heavy2119/Belt-tensioner-AC-Servo-/README.md

# Belt Tensioner (AC Servo Version)

AC Servo based belt tensioner for **Sim Racing**, built using a Panasonic Minas A4 servo system.

This project is based on the original DIY belt tensioner project:

https://www.simhubdash.com/diy-belt-tensionner/

---

# Overview

This project uses:

* Panasonic **Minas A4 100W AC Servo**
* **ATG PGX42-20** planetary reducer
* Arduino control
* Hall sensor for homing

The goal was to build a **quiet and responsive belt tensioner system** for SimHub.

---

<p align="left">
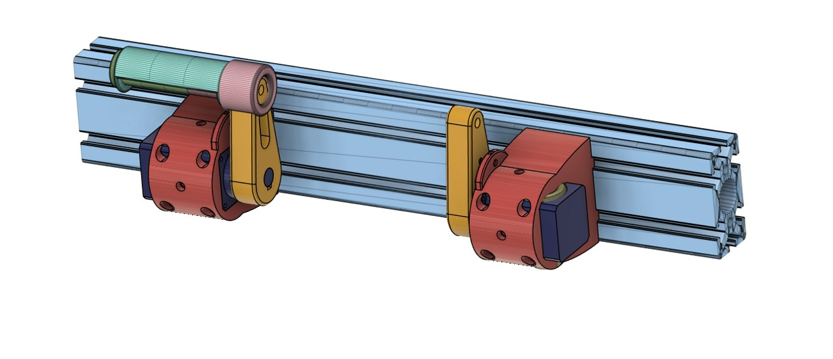
[picture p1: image/전체사진.jpg]

</p>

<p align="left">
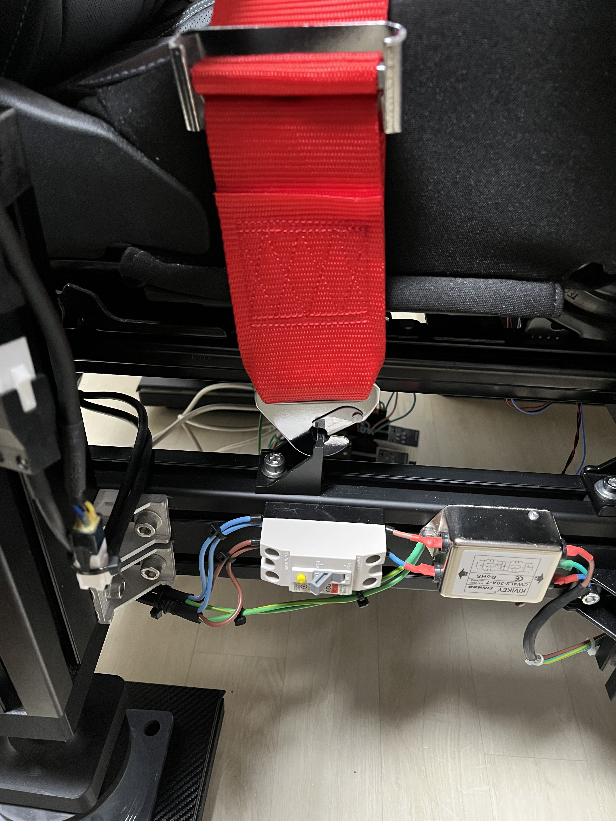
[picture p2: image/belt.jpg]

</p>

---

# Hardware

## Main Components

<p align="left">
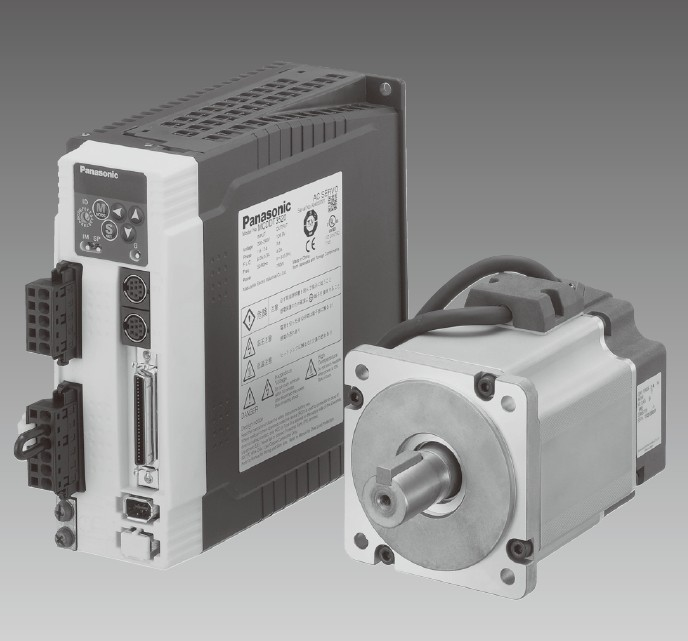
[picture p3: image/MinasA4.jpg]

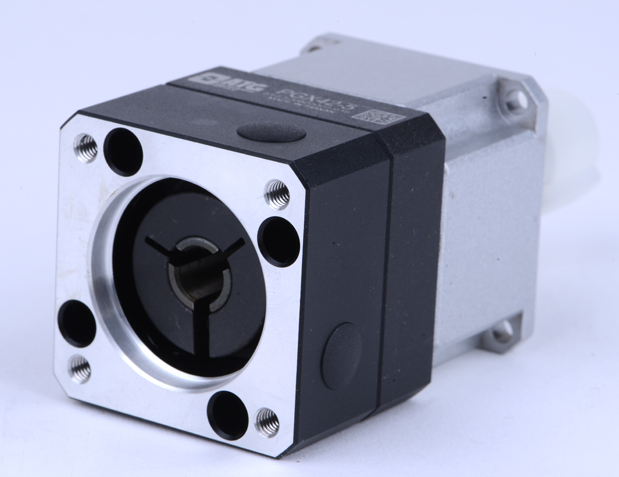
[picture p4: image/pgx42.png]

</p>

| Component | Model | Note |
| --- | --- | ---|
| Servo Driver | MADDT1205 | |
| Servo Motor  | MSMD012S1A | |
| Reducer | ATG PGX42-20 | |
| Reducer | PLF042-L2-8-30-46-M4| 타오바오에서 구매 가능 [Buy](https://item.taobao.com/item.htm?id=677023837529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)|

---

# Arduino Wiring (Board Type)

<p align="left">
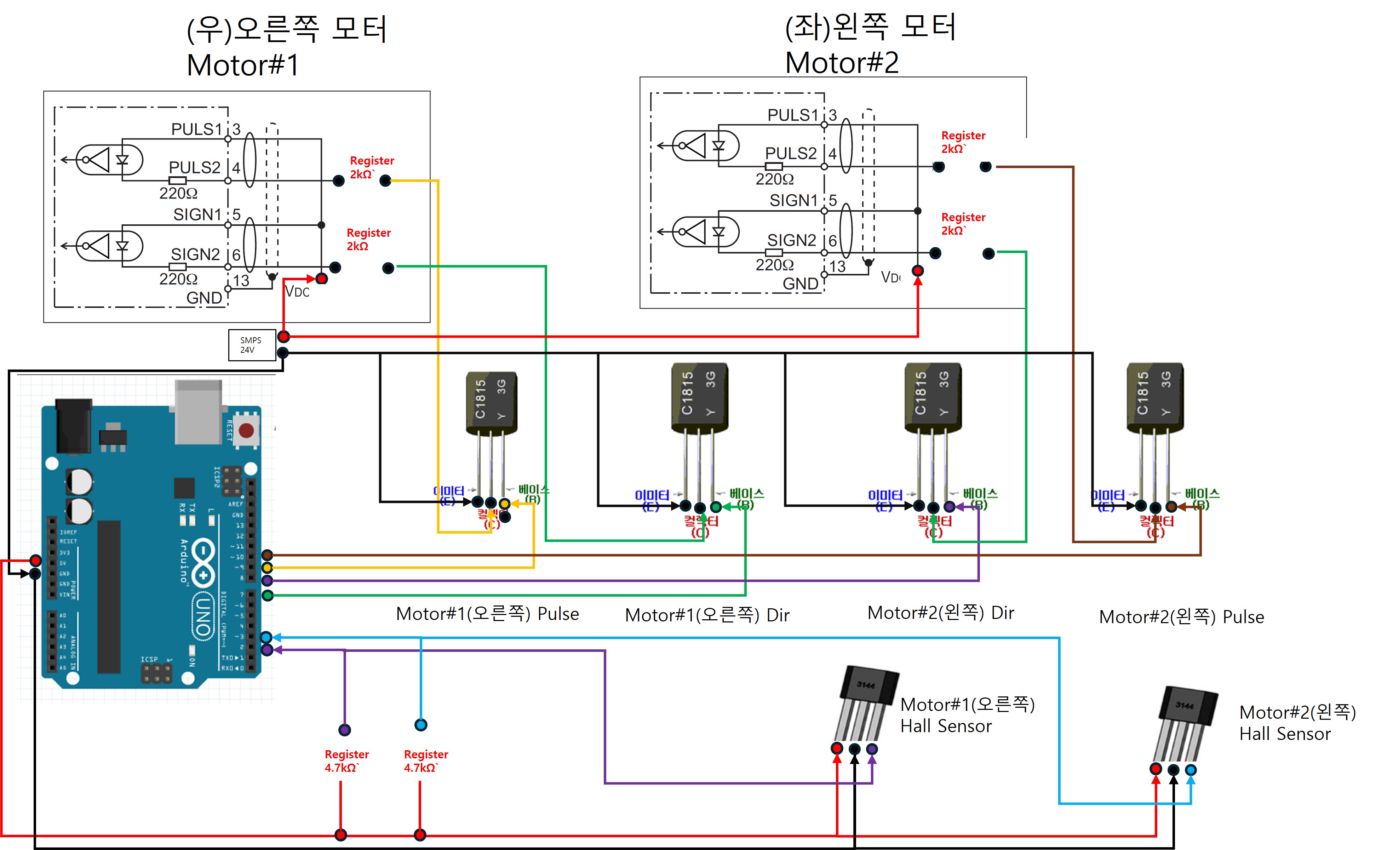
[picture p5: image/Arduino Wirling.jpg]

</p>

| Function | Motor 1 | Motor 2 | Servo I/O |
| --- | --- | --- | --- |
| Pulse | 9 | 10 | 4 |
| Direction | 7 | 8 | 6 |
| Hall Sensor | 2 | 3 | - |
| 24V+ | | | 3,5 |

# Arduino Wiring (PCB Type / I/O(3,4,5,6))

<p align="left">
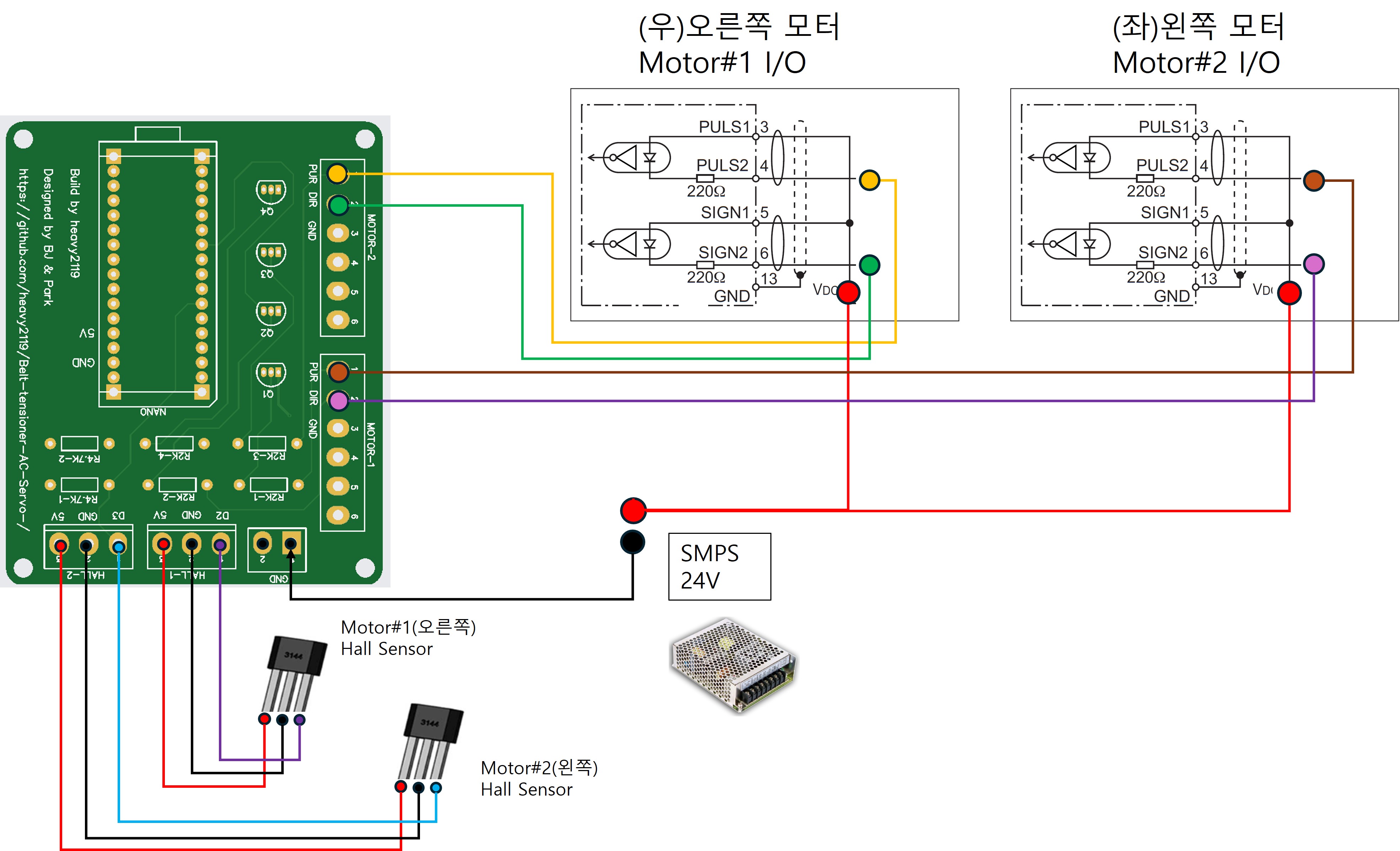
[picture p6: image/PCB Type 3,4,5,6 Pin활용.jpg]

</p>

| Function | Motor 1 | Motor 2 | Servo I/O |
| --- | --- | --- | --- |
| Pulse | 9 | 10 | 4 |
| Direction | 7 | 8 | 6 |
| Hall Sensor | 2 | 3 | - |
| 24V+ | | | 3,5 |

# Arduino Wiring (PCB Type / OPC사용 I/O(1,4,2,6))

<p align="left">
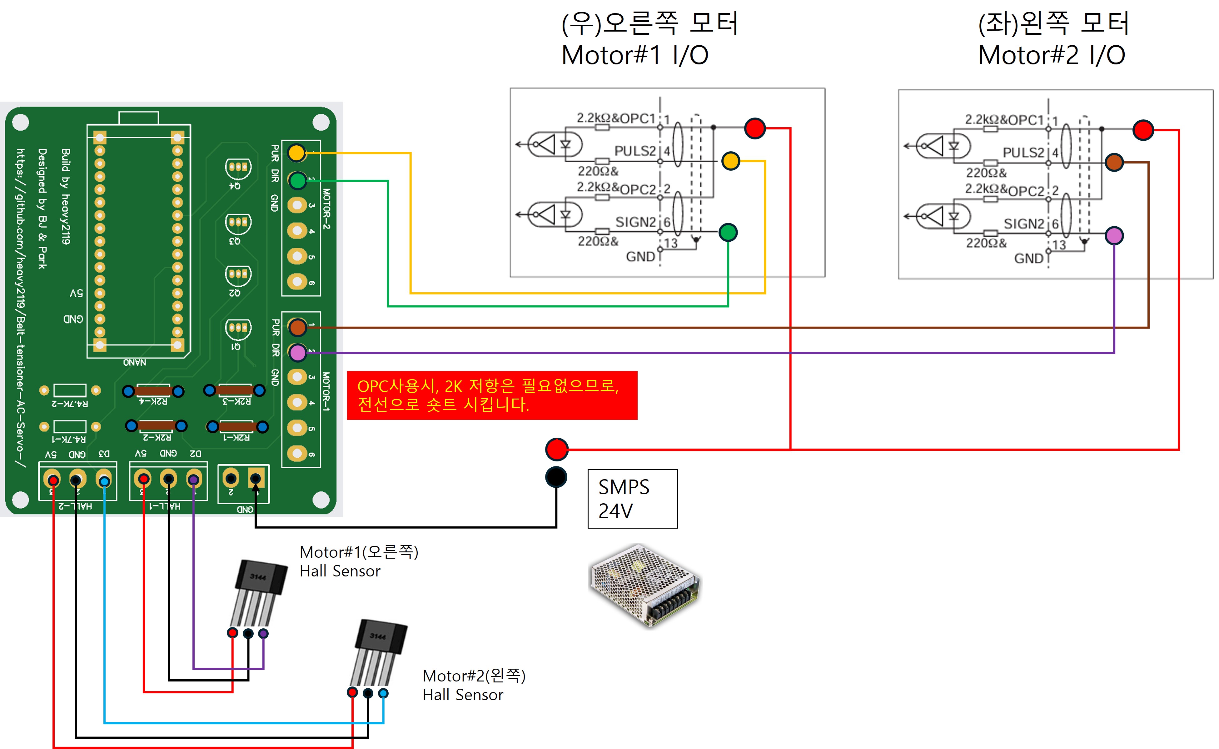
[picture p7: image/PCB Type 1,4,2,6 Pin활용.jpg]

</p>

| Function | Motor 1 | Motor 2 | Servo I/O |
| --- | --- | --- | --- |
| Pulse | 9 | 10 | 4 |
| Direction | 7 | 8 | 6 |
| Hall Sensor | 2 | 3 | - |
| 24V+ | | | 1,2 |

# Arduino Wiring (NEW PCB Type Type /OPC사용 I/O(1,4,2,6))

<p align="left">
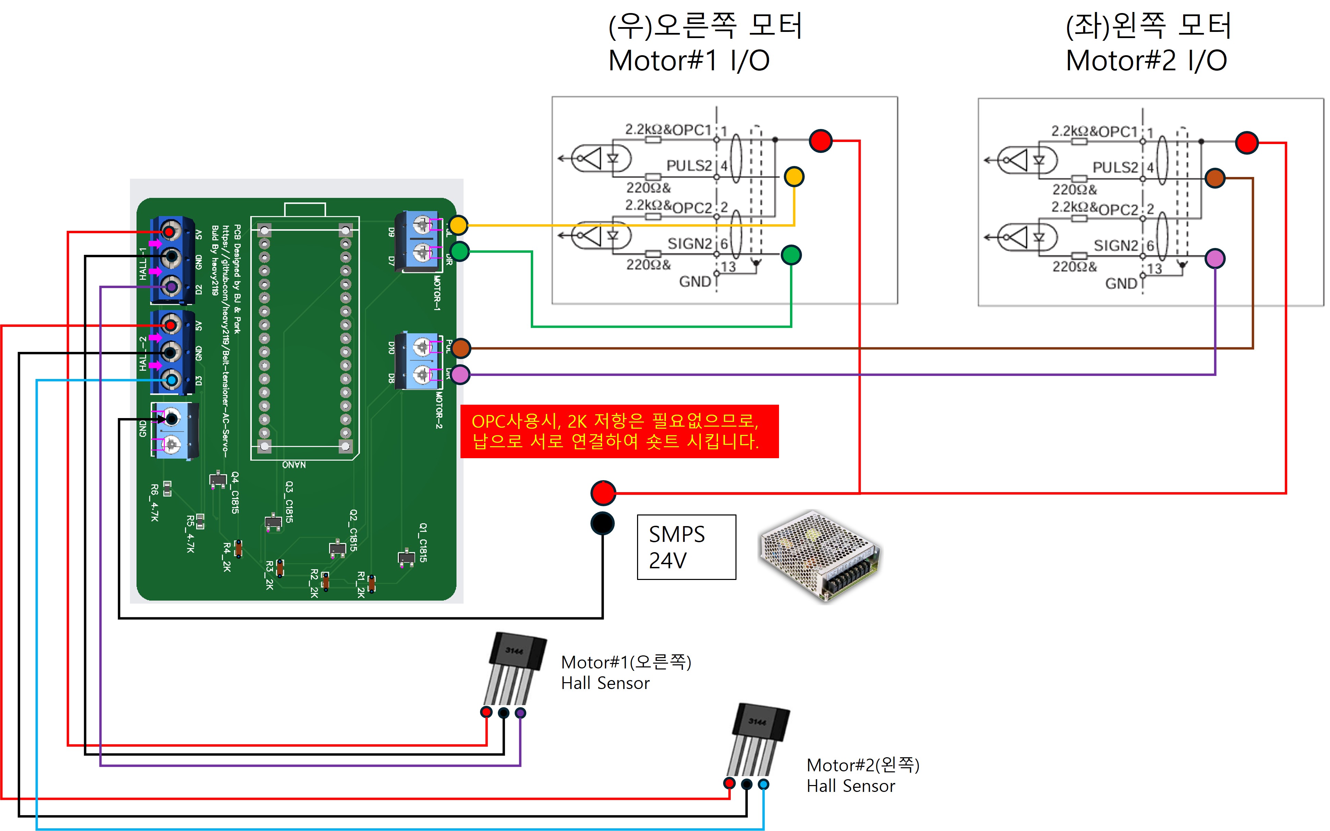
[picture p8: image/NEW PCB.jpg]

</p>

| Function | Motor 1 | Motor 2 | Servo I/O |
| --- | --- | --- | --- |
| Pulse | 9 | 10 | 4 |
| Direction | 7 | 8 | 6 |
| Hall Sensor | 2 | 3 | - |
| 24V+ | | | 1,2 |

---

# Servo I/O Pin Map

<p align="left">
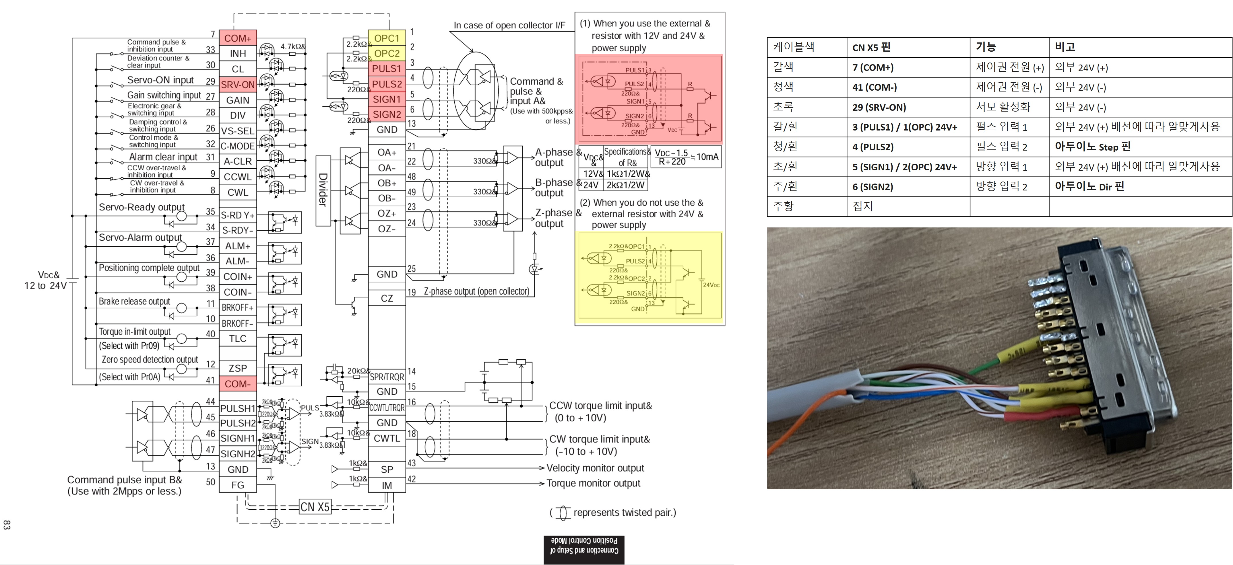
[picture p9: image/IO Wirling.jpg]

</p>

| Pin | Signal | Connection |
| --- | --- | --- |
| 3 | PULS1 / OPC1  | 24V+ |
| 4 | PULS2 | 0V (<- Arduino INPUT) |
| 5 | SIGN1 / OPC2  | 24V+ |
| 6 | SIGN2 | 0V (<- Arduino INPUT) |
| 7 | COM+ | 24V+ |
| 29  | SRV-ON | 0V |
| 41  | COM- | 0V |

---

# Minas A4 Servo Drive Parameters

| Parameter | Description | Value | Note |
| --- | --- | ----- | ----- |
| Pr02 | Control Mode | 0 | |
| Pr04 | Disable Over-travel Input | 1 | |
| Pr40 | Command Pulse Input | 0 | |
| Pr42 | Pulse Input Mode | 3 | |
| Pr43 | Pulse Input Inhibition | 1 | |
| Pr4E | Counter Clear Mode | 2 | |
| Pr4B | Electronic Gear Denominator | 150 | 감속비 20:1 |

# Minas A5 Servo Drive Parameters

| Parameter | Description | Value | Note |
| --- | --- | ----- |----- |
| Pr01 | Control Mode | 0 | |
| Pr05 | Disable Over-travel Input | 0 | |
| Pr06 | Command Pulse Input | 1 | |
| Pr07 | Pulse Input Mode | 3 | |
| Pr08 | Command pulse counts per one motor revolution | 600 |  감속비 5:1 |

---

# Part List (모든전장품은 여유분을 꼭 가지고 사세요.) 

| Name | EA | Site | Note | 
| --- | --- | --- | --- |
| PCB  | 1 |  [Buy](https://github.com/heavy2119/Belt-tensioner-AC-Servo-/tree/main/PCB)| Gerber_Belt-tensioner.ZIP / BOM / CPL << 옵션에 PCB어샘블리 선택하고 첨부, BOM 단계에서 없는파츠는 선택할것, KF301은 구성요소배치에서 회전시킬것!
| PCB  | 1 |  [Buy](https://github.com/heavy2119/Belt-tensioner-AC-Servo-/tree/main/PCB)| Gerber_Belt-tensioner-AC-Servo_PCB_Belt-tensioner-AC-Servo_2026-04-20.zip / 수동 납땜 버전용!!, 이버전은 아래 Part가 전부 필요.
| Arduino Nano  | 1 |  [Buy](https://smartstore.naver.com/misoparts/products/9353232362)| 
| Arduino Nano 소켓  | 1 |  [Buy](https://smartstore.naver.com/misoparts/products/5685496972)| 
| PCB 소켓  | 1 |  [Buy](https://ko.aliexpress.com/item/1005010243767312.html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)|  KF301-5.0-2P / PCB 어샘블리 버전 주문시 불필요!!
| PCB 소켓  | 2 |  [Buy](https://ko.aliexpress.com/item/1005010243767312.html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)|  KF301-5.0-3P / PCB 어샘블리 버전 주문시 불필요!!
| PCB 소켓  | 2 |  [Buy](https://ko.aliexpress.com/item/1005010243767312.html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)|  KF301-5.0-6P / PCB 어샘블리 버전 주문시 불필요!!
| 드라이버 I/O 케이블  | 2 |  [Buy](https://item.taobao.com/item.htm?id=1012712594796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)| 松下X4控制线 << 항목 선택 주문
| 드라이버 엔코더,전원 케이블  | 2 |  [Buy](https://item.taobao.com/item.htm?id=1043514073575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)| 松下A4A5编码器线+动力线一套 << 항목 선택 주문
| 12 or 24V SMPS | 1 | [Buy](https://smartstore.naver.com/jooyontns/products/498258307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)|  
| A3144 Hall Sensor | 2 | [Buy](https://smartstore.naver.com/misoparts/products/7329734570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) |  원점 감지용
| C1815 TR | 4 | [Buy](https://smartstore.naver.com/misoparts/products/11061354807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)|  PCB 어샘블리 버전 주문시 불필요!!
| 저항 1k | 8 | [Buy](https://smartstore.naver.com/misoparts/products/12929684410) | 2K 저항이 필요, 1K 2개 직렬사용 / PCB 어샘블리 버전 주문시 불필요!!
| 저항 1K ~ 4.7k | 2 | [Buy](https://smartstore.naver.com/misoparts/products/12929684410) | 평균 4.7K옴을 사용하나, 환경에 따라 틀림 / 풀업 저항 사용(노이즈억제) / PCB 어샘블리 버전 주문시 불필요!!
| 전선 AWG24 X 8C | 1 | [Buy](https://smartstore.naver.com/ctkmall/products/9391403956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)| 10미터 정도?
| Magnet 6X3 | 2 |  [Buy](https://smartstore.naver.com/3hl) | 네오디움 자석
| 4Point Belt | 1 | [Buy](https://item.taobao.com/item.htm?id=839255746083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)  | 안전밸트
| Die-Casting Bracket for Profile 40X40 | 2 |  | 안전벨트 걸이  |
| M4X10 | 8 |  | Motor ↔ 감속기 체결용 볼트 (여유분있게 구매) |
| M5X15 | 8 |  | Motor 3D Print 체결용 볼트 (여유분있게 구매) |
| M6X110 | 2 |  | 안전벨트 체결용 볼트 (여유분있게 구매) |
| M8X15 | 8 |  | 다이닝캐스팅 고정용 볼트 (여유분있게 구매)  |
| M6 NUT | 2 |  | 안전벨트 체결용 너트 (여유분있게 구매)  |
| 40 T Nut | 2 |  | 다이닝캐스팅 고정용 T Nut (여유분있게 구매)  |

---

# 3D Print

| Name |  EA  | Note |
| --- |  --- |--- |
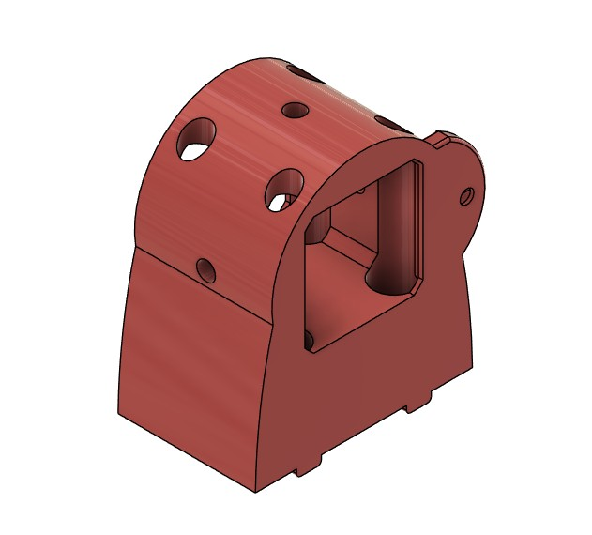
[picture p10: image/감속기마운트(좌).jpg]
|   |  1EA  |  ATG PGX42-20 전용 (내경 43mm)
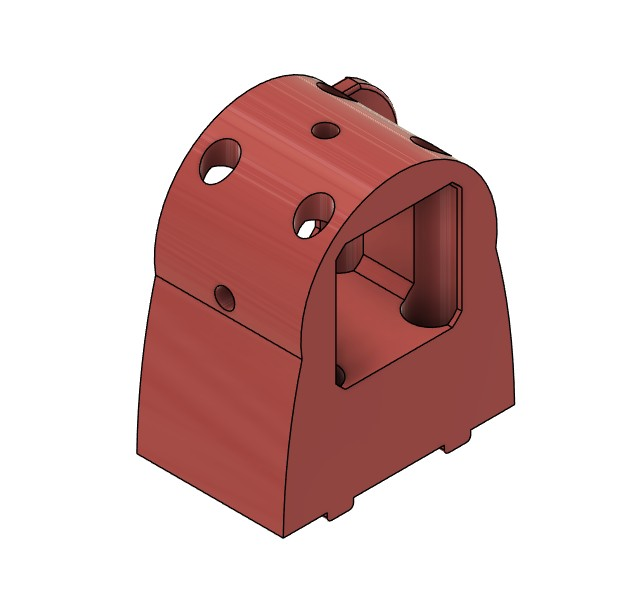
[picture p11: image/감속기마운트(우).jpg]
|  |  1EA |  ATG PGX42-20 전용 (내경 43mm)
|   |  1EA  | (내경 42.7mm)
|  |  1EA | (내경 42.7mm)
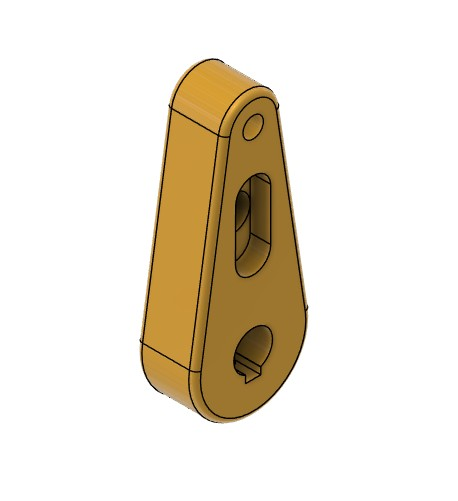
[picture p12: image/레버(좌).jpg]
|  | 1EA
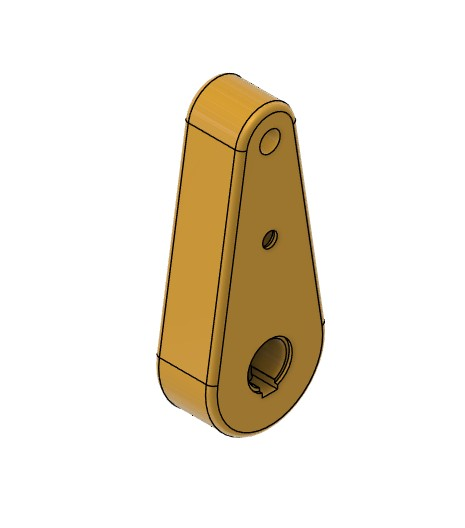
[picture p13: image/레버(우).jpg]
|  |  1EA
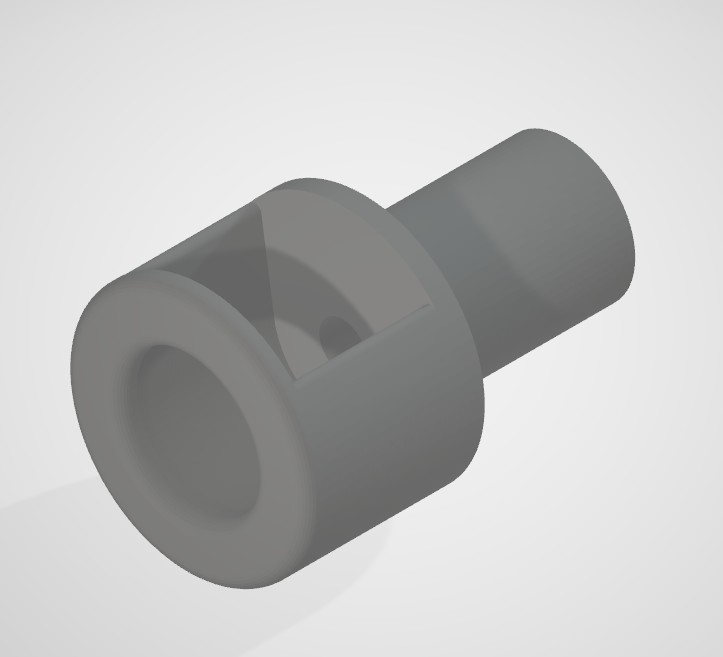
[picture p14: image/Arm1.jpg]
|  |  1EA | By https://www.simhubdash.com/diy-belt-tensionner/
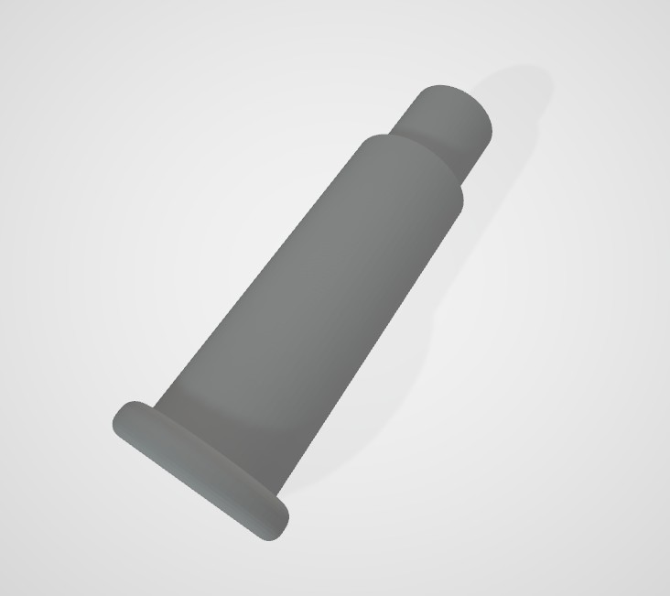
[picture p15: image/Rod2_76mm.jpg]
|  |  1EA | By https://www.simhubdash.com/diy-belt-tensionner/
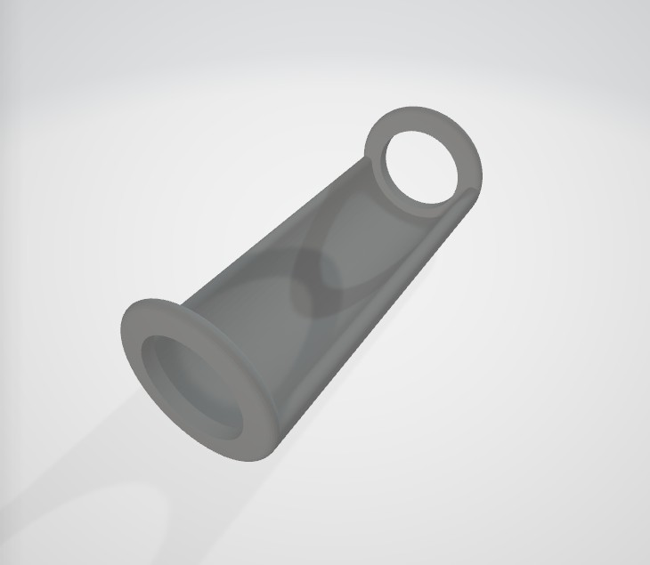
[picture p16: image/BeltClamp_76mm.jpg]
|  |  1EA | By https://www.simhubdash.com/diy-belt-tensionner/

# Arduino Source Check List

| Name | Value | 
| --- | --- |
| totalWorkingRange | 1500 |
| stepper1_directionPin |  7 |
| stepper1_enablePin  | 11 |
| stepper1_hallSensorPin |  2 |
| stepper2_directionPin | 8 |
| stepper2_enablePin | 13 |
| stepper2_hallSensorPin | 3 |

## 🇰🇷 아두이노 테스트 주의사항
초기 실행시 const bool sensorTestMode = false; 값을 True로 변경하여
자석을 감지시켜 센서가 정상적으로 동작하는지 확인한다.

정상 동작 확인후 true로 변경한다

이후 심허브에서 캘리브레이션을 실행하면 아래의 동영상과 같이
초기화가 되어야 한다

주의 : 절대 리그에 장착한 상태에서 테스트 하지말고 바닥에 두고
테스트 할것. 초기화 불가시 arm이 파손될수 있음

Watch the video (https://youtube.com/shorts/3xaYN5WgsHA)

---

## 🇺🇸 Arduino Test Notice

During the initial run, change the value of const bool sensorTestMode = false; to true, 
then trigger the magnet to verify that the sensor is operating correctly.

---

# Assembly Notes

<p align="left">
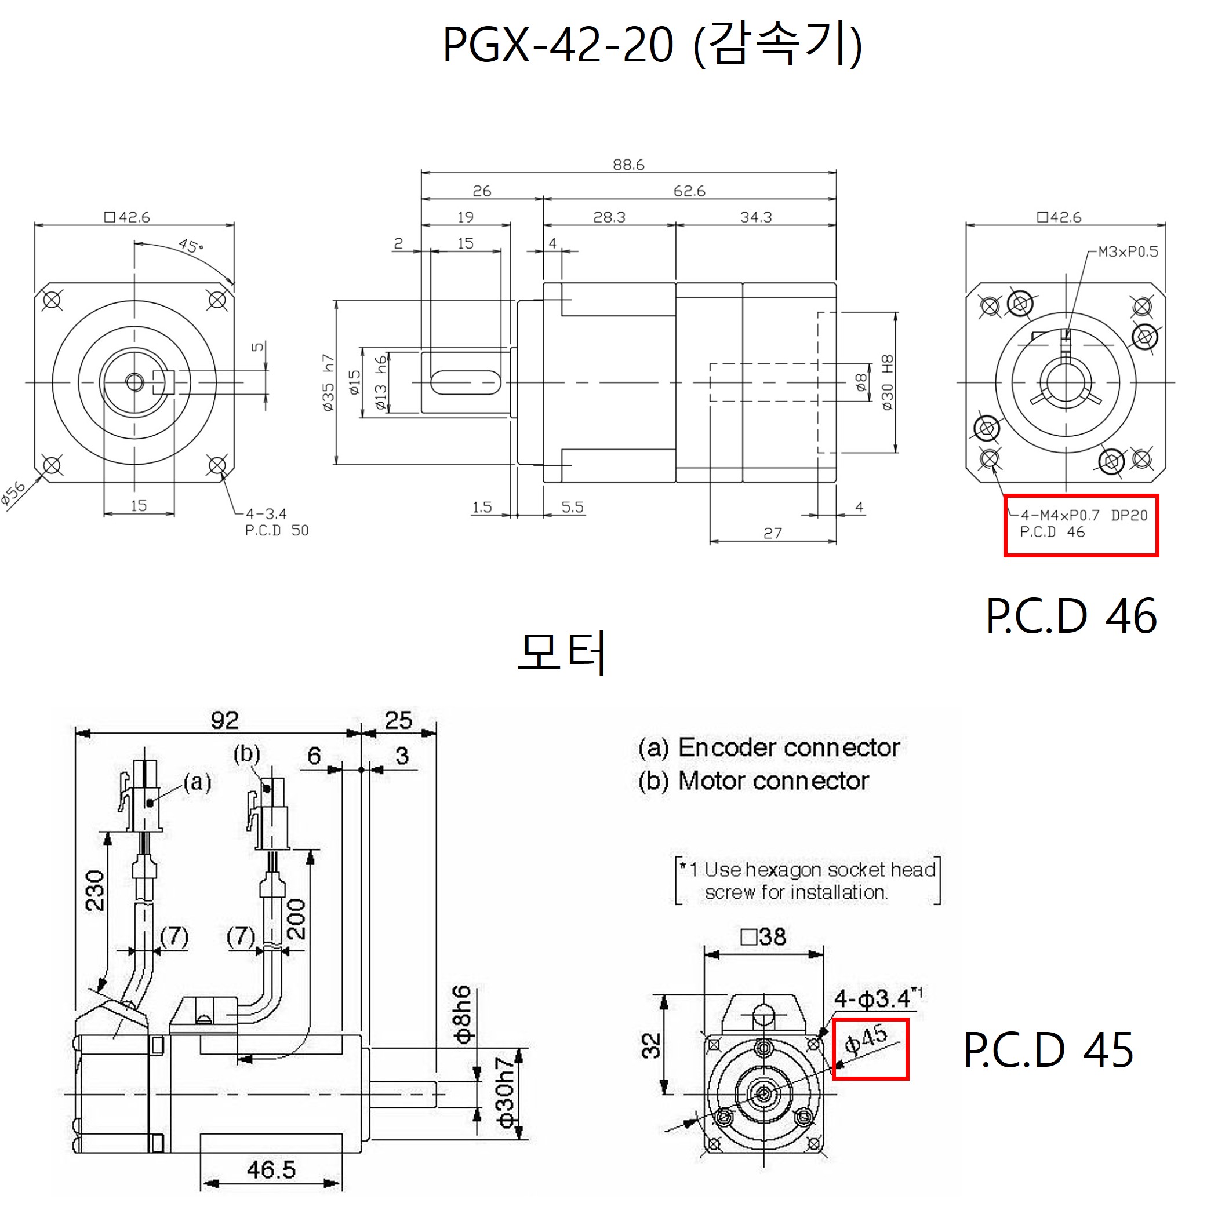
[picture p17: image/size.jpg]

</p>

## 🇰🇷 조립 주의사항

- 감속기 P.C.D : 46 mm  
- 모터 P.C.D : 45 mm  

두 부품의 P.C.D 차이가 **1 mm** 있어 볼트 구멍이 정확히 맞지 않습니다.  

따라서 모터쪽 **M4 볼트가 들어갈 수 있도록 드릴로 구멍을 확장해야 합니다.**  

저는 약 **Ø6.5 mm** 정도로 구멍을 확장하여 사용했습니다.

---

## 🇺🇸 Assembly Notes

- Gearbox P.C.D: 46 mm  
- Motor P.C.D: 45 mm  

Because there is a **1 mm difference in the P.C.D**, the bolt holes do not align perfectly.  

Therefore, **the holes need to be enlarged with a drill** so that the M4 bolts on the motor side can fit.  

In my case, I enlarged the holes to approximately **Ø6.5 mm**.

---

# Credits

Original project inspiration:

DIY Belt Tensioner
https://www.simhubdash.com/diy-belt-tensionner/
