heavy2119/Belt-tensioner-AC-Servo-/image/Driver Parameter Setting.jpg

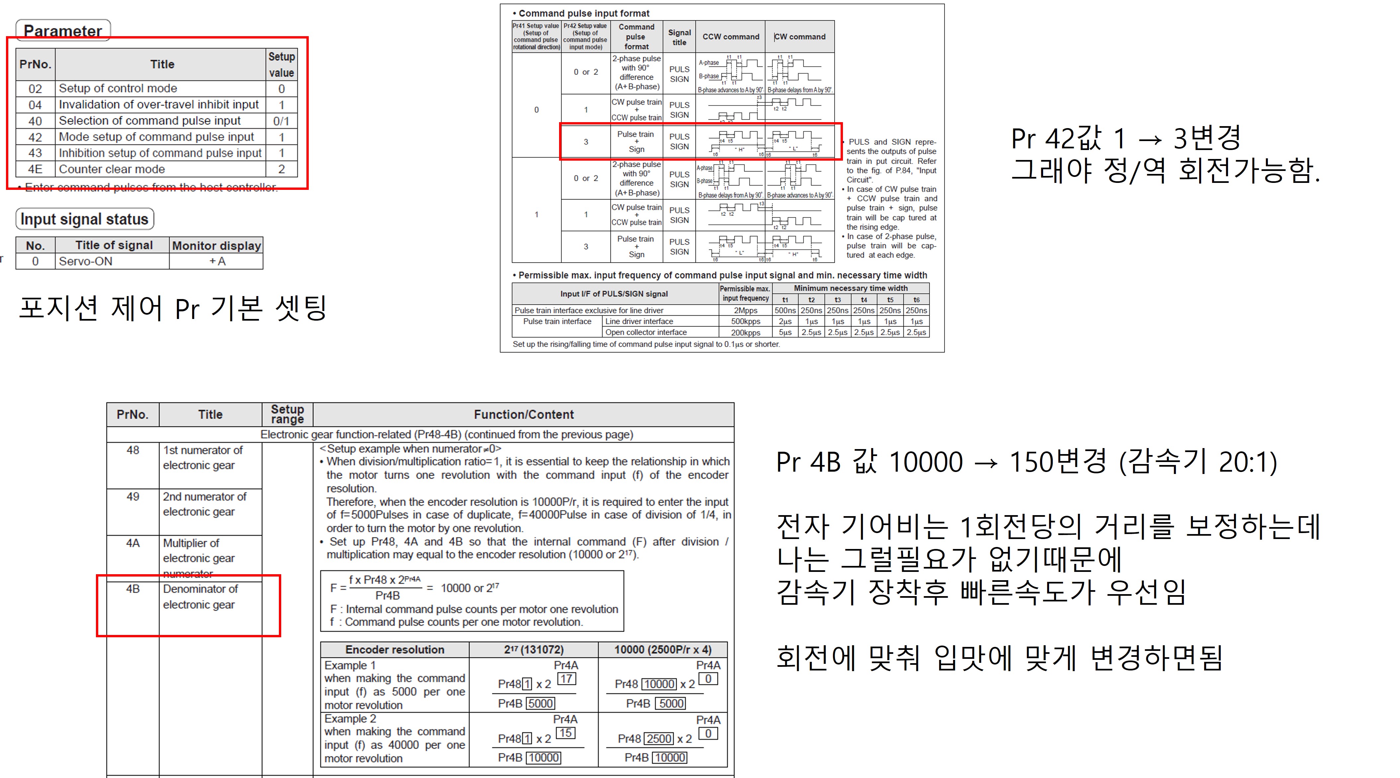
image/Driver Parameter Setting.jpg
