heavy2119/Belt-tensioner-AC-Servo-/3D Print/레버 감속기마운트 42.7(좌)).stl

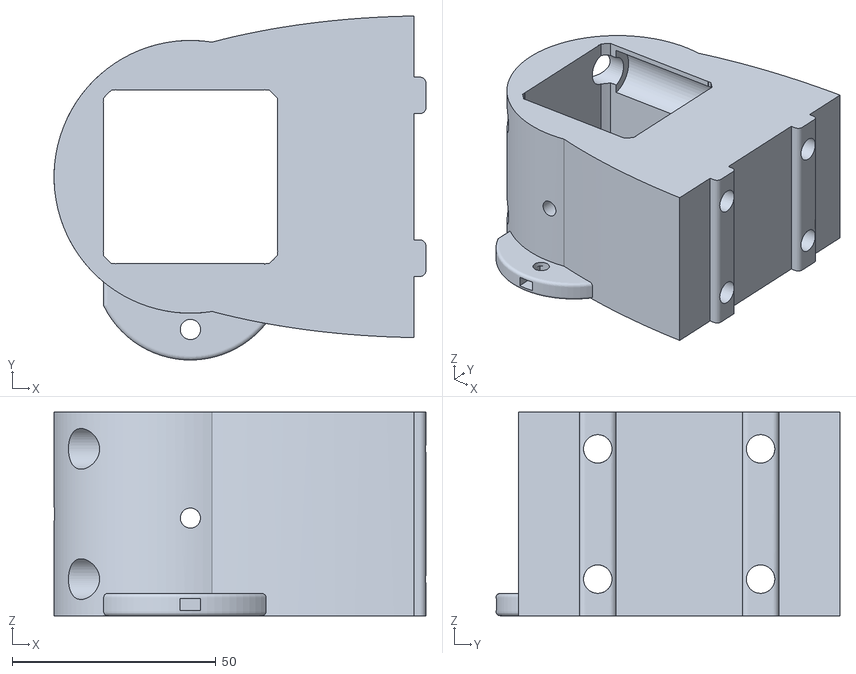
[picture p19: CAD file, 2026-08-10]
3D Print/레버 감속기마운트 42.7(좌)).stl
91.4 x 84.5 x 50.0
