heavy2119/Belt-tensioner-AC-Servo-/3D Print/레버(좌) Nut추가.stl

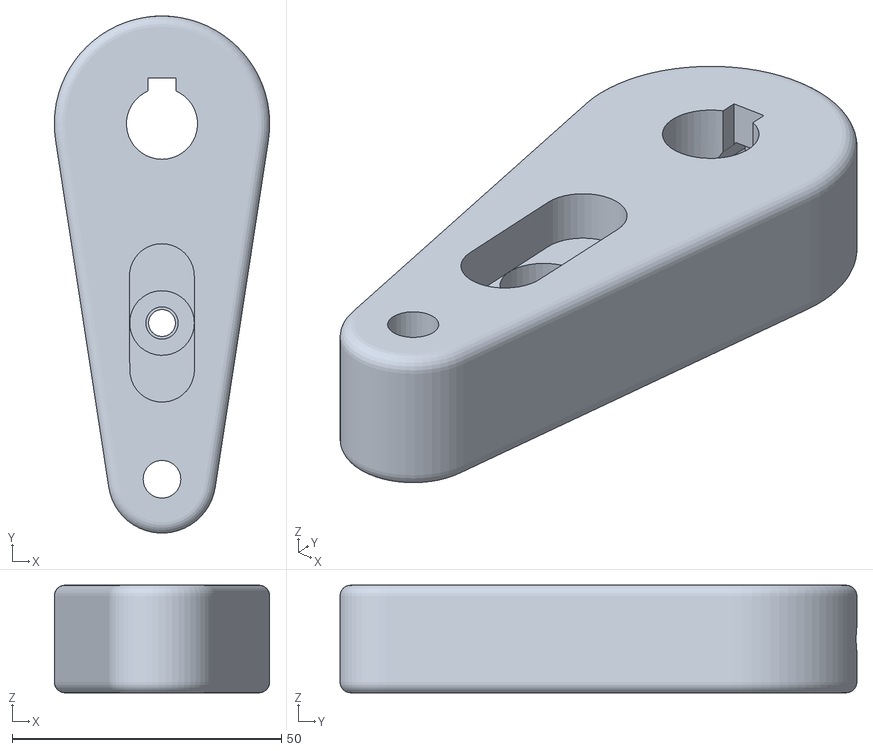
[picture p20: CAD file, 2026-06-20]
3D Print/레버(좌) Nut추가.stl
40.0 x 96.0 x 20.0
