heavy2119/Belt-tensioner-AC-Servo-/3D Print/BeltClamp_76mm.stl

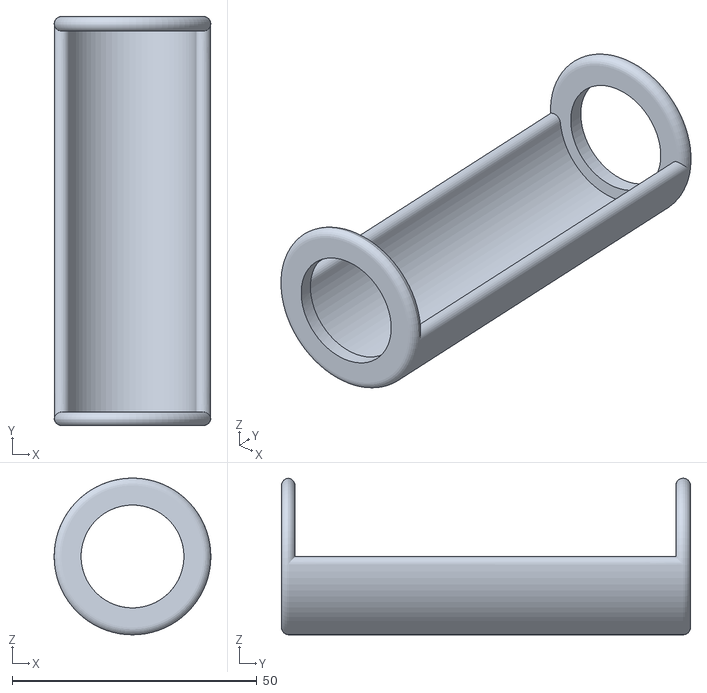
[picture p21: CAD file, 2026-04-01]
3D Print/BeltClamp_76mm.stl
32.0 x 83.5 x 32.0
