heavy2119/Belt-tensioner-AC-Servo-/3D Print/Arm1.stl

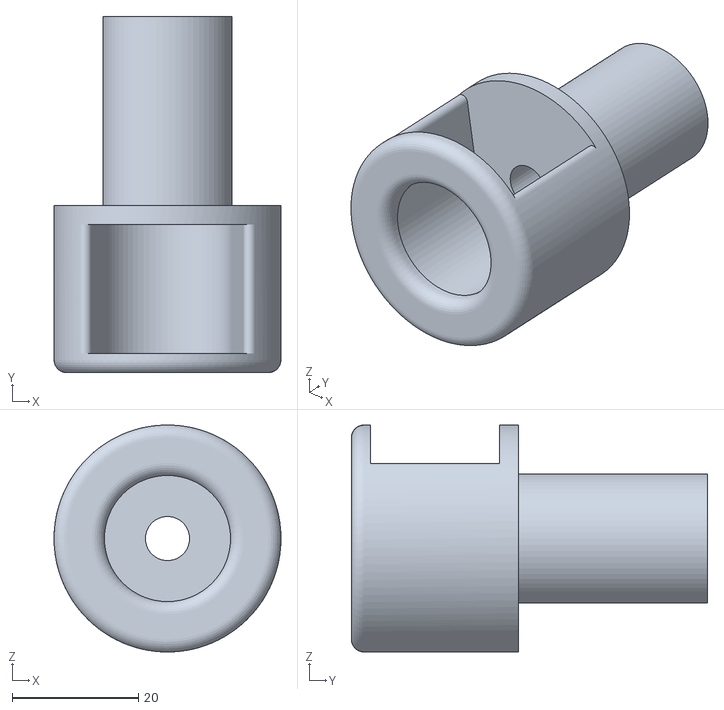
[picture p22: CAD file, 2026-04-01]
3D Print/Arm1.stl
36.0 x 56.5 x 36.0
