heavy2119/Belt-tensioner-AC-Servo-/3D Print/Rod2_76mm.stl

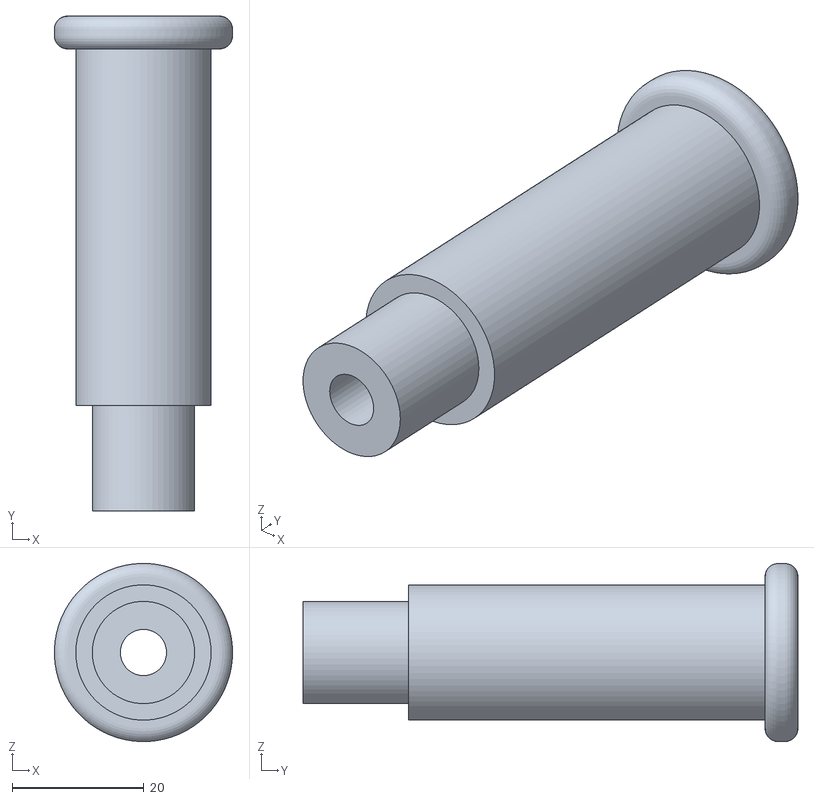
[picture p23: CAD file, 2026-04-01]
3D Print/Rod2_76mm.stl
27.0 x 75.0 x 27.0
