heavy2119/Belt-tensioner-AC-Servo-/(list of files, cad)

Other CAD files:
3D Print/레버 감속기마운트 42.7(우)).stl
3D Print/감속기마운트(좌).stl
3D Print/감속기마운트(우).stl
3D Print/레버 감속기마운트.f3d
