heavy2119/Belt-tensioner-AC-Servo-/(commit log)

2026-04-10 README.md 업데이트
2026-07-08 Create Arduino
2026-08-07 Update Arduino Wiring section titles in README
